bson/ns32k/3d/54020-32030LF.step

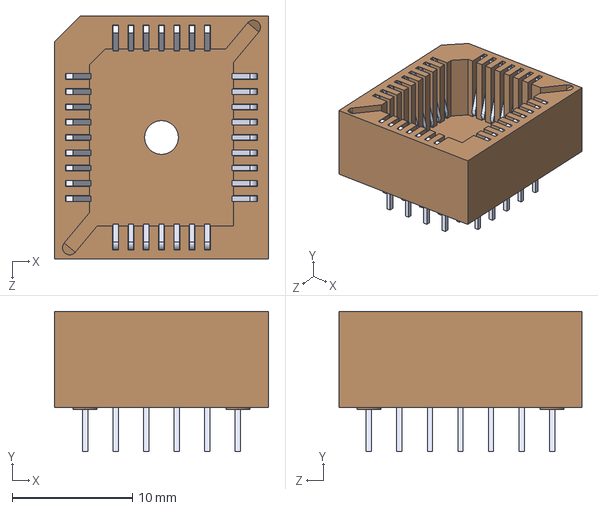
[picture p1: CAD file, 2024-07-24]
3d/54020-32030LF.step
17.8 x 11.7 x 20.2 mm
