bson/ns32k/ns32k.kicad_pcb

## KiCad design ns32k.kicad_pcb (2024-08-19)

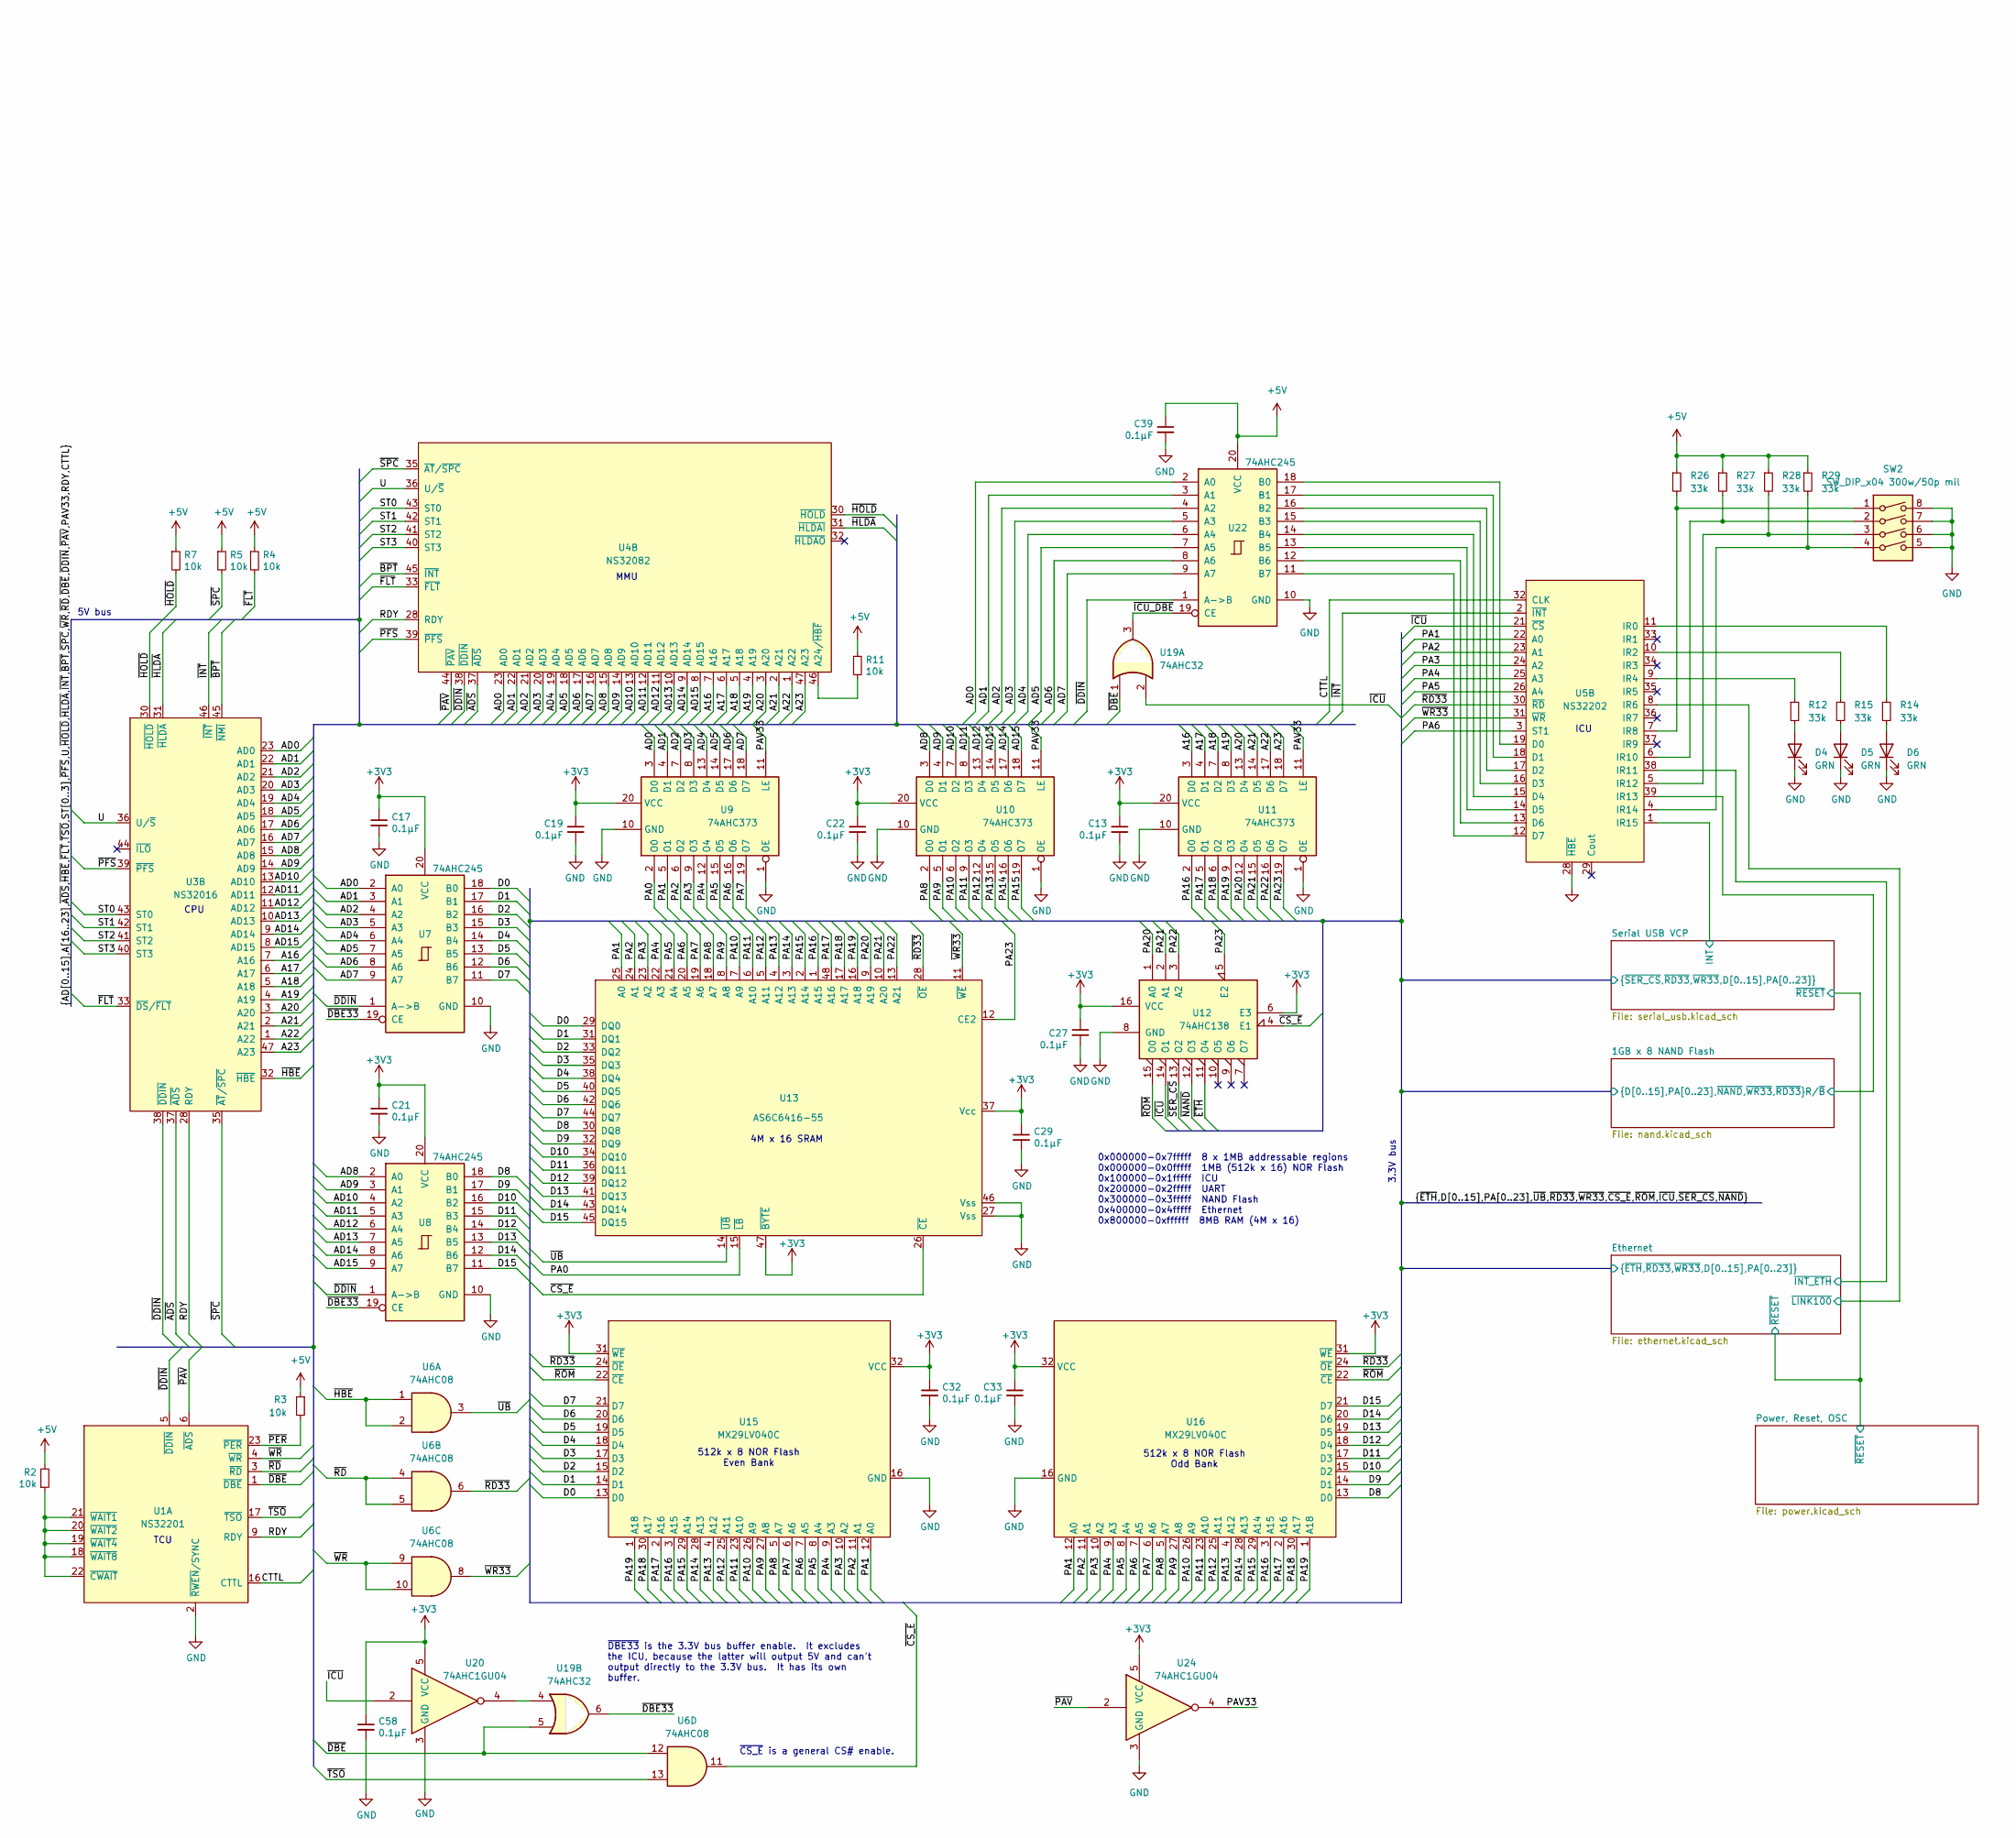
[picture p2: schematic ns32k.kicad_sch, Toy32k]

Parts:
C13, C17, C19, C21, C22, C27, C29, C32, C33, C39, C58: 0.1µF; C_0402_1005Metric; LCSC C3012376
D4, D5, D6: GRN; D_0603_1608Metric; LCSC C5246833
R2, R3, R4, R5, R7, R11: 10k; R_0402_1005Metric; LCSC C375970
R12, R14, R15, R26, R27, R28, R29: 33k; R_0402_1005Metric; LCSC C2906928
SW2: SW_DIP_x04 300w/50p mil; SW_DIP_SPSTx04_Slide_Copal_CHS-04B_W7.62mm_P1.27mm; LCSC C18198092
U1: NS32201; DIP-24_W15.24mm_Socket
U3: NS32016; DIP-48_W15.24mm_Socket
U4: NS32082; DIP-48_W15.24mm_Socket
U5: NS32202; DIP-40_W15.24mm_Socket
U6: 74AHC08; TSSOP-14_4.4x5mm_P0.65mm; LCSC C842279
U7, U8, U22: 74AHC245; TSSOP-20_4.4x6.5mm_P0.65mm; LCSC C5516
U9, U10, U11: 74AHC373; TSSOP-20_4.4x6.5mm_P0.65mm; LCSC C80242
U12: 74AHC138; TSSOP-16_4.4x5mm_P0.65mm; LCSC C352950
U13: AS6C6416-55; TSOP-I-48_18.4x12mm_P0.5mm; LCSC C1349200
U15, U16: MX29LV040C; PLCC-32_THT-Socket
U19: 74AHC32; TSSOP-14_4.4x5mm_P0.65mm; LCSC C2868909
U20, U24: 74AHC1GU04; SOT-23-5; LCSC C22384791

Connections:
+3V3: C13.1, C17.1, C19.1, C21.1, C22.1, C27.1, C29.1, C32.1, C33.1, C58.1, U7.20 (VCC), U8.20 (VCC), U9.20 (VCC), U10.20 (VCC), U11.20 (VCC), U12.6 (E3), U12.16 (VCC), U13.37 (Vcc), U13.47 (~BYTE), U15.31 (~WE), U15.32 (VCC), U16.31 (~WE), U16.32 (VCC), U20.5 (VCC), U24.5 (VCC); also elsewhere on the board
+5V: C39.1, R2.2, R3.1, R4.1, R5.1, R7.1, R11.1, R26.1, R27.1, R28.1, R29.1, U22.20 (VCC); also elsewhere on the board
/1GB x 8 NAND Flash/R/~B: U5.39 (IR13); also elsewhere on the board
/A16: U3.7 (A16), U4.7 (A16), U11.3 (D0)
/A17: U3.6 (A17), U4.6 (A17), U11.4 (D1)
/A18: U3.5 (A18), U4.5 (A18), U11.7 (D2)
/A19: U3.4 (A19), U4.4 (A19), U11.8 (D3)
/A20: U3.3 (A20), U4.3 (A20), U11.13 (D4)
/A21: U3.2 (A21), U4.2 (A21), U11.14 (D5)
/A22: U3.1 (A22), U4.1 (A22), U11.17 (D6)
/A23: U3.47 (A23), U4.47 (A23), U11.18 (D7)
/AD0: U3.23 (AD0), U4.23 (AD0), U7.2 (A0), U9.3 (D0), U22.2 (A0)
/AD1: U3.22 (AD1), U4.22 (AD1), U7.3 (A1), U9.4 (D1), U22.3 (A1)
/AD2: U3.21 (AD2), U4.21 (AD2), U7.4 (A2), U9.7 (D2), U22.4 (A2)
/AD3: U3.20 (AD3), U4.20 (AD3), U7.5 (A3), U9.8 (D3), U22.5 (A3)
/AD4: U3.19 (AD4), U4.19 (AD4), U7.6 (A4), U9.13 (D4), U22.6 (A4)
/AD5: U3.18 (AD5), U4.18 (AD5), U7.7 (A5), U9.14 (D5), U22.7 (A5)
/AD6: U3.17 (AD6), U4.17 (AD6), U7.8 (A6), U9.17 (D6), U22.8 (A6)
/AD7: U3.16 (AD7), U4.16 (AD7), U7.9 (A7), U9.18 (D7), U22.9 (A7)
/AD8: U3.15 (AD8), U4.15 (AD8), U8.2 (A0), U10.3 (D0)
/AD9: U3.14 (AD9), U4.14 (AD9), U8.3 (A1), U10.4 (D1)
/AD10: U3.13 (AD10), U4.13 (AD10), U8.4 (A2), U10.7 (D2)
/AD11: U3.12 (AD11), U4.12 (AD11), U8.5 (A3), U10.8 (D3)
/AD12: U3.11 (AD12), U4.11 (AD12), U8.6 (A4), U10.13 (D4)
/AD13: U3.10 (AD13), U4.10 (AD13), U8.7 (A5), U10.14 (D5)
/AD14: U3.9 (AD14), U4.9 (AD14), U8.8 (A6), U10.17 (D6)
/AD15: U3.8 (AD15), U4.8 (AD15), U8.9 (A7), U10.18 (D7)
/CTTL: U1.16 (CTTL), U5.32 (CLK)
/D0: U7.18 (B0), U13.29 (DQ0), U15.13 (D0); also elsewhere on the board
/D1: U7.17 (B1), U13.31 (DQ1), U15.14 (D1); also elsewhere on the board
/D2: U7.16 (B2), U13.33 (DQ2), U15.15 (D2); also elsewhere on the board
/D3: U7.15 (B3), U13.35 (DQ3), U15.17 (D3); also elsewhere on the board
/D4: U7.14 (B4), U13.38 (DQ4), U15.18 (D4); also elsewhere on the board
/D5: U7.13 (B5), U13.40 (DQ5), U15.19 (D5); also elsewhere on the board
/D6: U7.12 (B6), U13.42 (DQ6), U15.20 (D6); also elsewhere on the board
/D7: U7.11 (B7), U13.44 (DQ7), U15.21 (D7); also elsewhere on the board
/D8: U8.18 (B0), U13.30 (DQ8), U16.13 (D0)
/D9: U8.17 (B1), U13.32 (DQ9), U16.14 (D1)
/D10: U8.16 (B2), U13.34 (DQ10), U16.15 (D2)
/D11: U8.15 (B3), U13.36 (DQ11), U16.17 (D3)
/D12: U8.14 (B4), U13.39 (DQ12), U16.18 (D4)
/D13: U8.13 (B5), U13.41 (DQ13), U16.19 (D5)
/D14: U8.12 (B6), U13.43 (DQ14), U16.20 (D6)
/D15: U8.11 (B7), U13.45 (DQ15), U16.21 (D7)
/Ethernet/~INT_ETH: U5.38 (IR11); also elsewhere on the board
/Ethernet/~LINK100: U5.8 (IR6); also elsewhere on the board
/PA0: U9.2 (O0), U13.15 (~LB)
/PA1: U5.22 (A0), U9.5 (O1), U13.25 (A0), U15.12 (A0), U16.12 (A0); also elsewhere on the board
/PA2: U5.23 (A1), U9.6 (O2), U13.24 (A1), U15.11 (A1), U16.11 (A1); also elsewhere on the board
/PA3: U5.24 (A2), U9.9 (O3), U13.23 (A2), U15.10 (A2), U16.10 (A2); also elsewhere on the board
/PA4: U5.25 (A3), U9.12 (O4), U13.22 (A3), U15.9 (A3), U16.9 (A3)
/PA5: U5.26 (A4), U9.15 (O5), U13.21 (A4), U15.8 (A4), U16.8 (A4)
/PA6: U5.3 (ST1), U9.16 (O6), U13.20 (A5), U15.7 (A5), U16.7 (A5)
/PA7: U9.19 (O7), U13.19 (A6), U15.6 (A6), U16.6 (A6)
/PA8: U10.2 (O0), U13.18 (A7), U15.5 (A7), U16.5 (A7)
/PA9: U10.5 (O1), U13.8 (A8), U15.27 (A8), U16.27 (A8)
/PA10: U10.6 (O2), U13.7 (A9), U15.26 (A9), U16.26 (A9)
/PA11: U10.9 (O3), U13.6 (A10), U15.23 (A10), U16.23 (A10)
/PA12: U10.12 (O4), U13.5 (A11), U15.25 (A11), U16.25 (A11)
/PA13: U10.15 (O5), U13.4 (A12), U15.4 (A12), U16.4 (A12)
/PA14: U10.16 (O6), U13.3 (A13), U15.28 (A13), U16.28 (A13)
/PA15: U10.19 (O7), U13.2 (A14), U15.29 (A14), U16.29 (A14)
/PA16: U11.2 (O0), U13.1 (A15), U15.3 (A15), U16.3 (A15)
/PA17: U11.5 (O1), U13.48 (A16), U15.2 (A16), U16.2 (A16)
/PA18: U11.6 (O2), U13.17 (A17), U15.30 (A17), U16.30 (A17)
/PA19: U11.9 (O3), U13.16 (A18), U15.1 (A18), U16.1 (A18)
/PA20: U11.12 (O4), U12.1 (A0), U13.9 (A19)
/PA21: U11.15 (O5), U12.2 (A1), U13.10 (A20)
/PA22: U11.16 (O6), U12.3 (A2), U13.13 (A21)
/PA23: U11.19 (O7), U12.5 (E2), U13.12 (CE2)
/PAV33: U9.11 (LE), U10.11 (LE), U11.11 (LE), U24.4
/RDY: U1.9 (RDY), U3.28 (RDY), U4.28 (RDY)
/ST0: U3.43 (ST0), U4.43 (ST0)
/ST1: U3.42 (ST1), U4.42 (ST1)
/ST2: U3.41 (ST2), U4.41 (ST2)
/ST3: U3.40 (ST3), U4.40 (ST3)
/Serial USB VCP/INT: U5.1 (IR15); also elsewhere on the board
/U: U3.36 (U/~S), U4.36 (U/~S)
/~ADS: U3.37 (~ADS), U4.37 (~ADS)
/~BPT: U3.45 (~NMI), U4.45 (~INT)
/~CS_E: U6.11, U12.4 (E1), U13.26 (~CE)
/~DBE33: U7.19 (CE), U8.19 (CE), U19.6
/~DBE: U1.1 (~DBE), U6.12, U19.1, U19.5
/~DDIN: U1.5 (~DDIN), U3.38 (~DDIN), U4.38 (~DDIN), U7.1 (A->B), U8.1 (A->B), U22.1 (A->B)
/~ETH: U12.11 (O4); also elsewhere on the board
/~FLT: R4.2, U3.33 (~DS/~FLT), U4.33 (~FLT)
/~HBE: U3.32 (~HBE), U6.1, U6.2
/~HLDA: U3.31 (~HLDA), U4.31 (~HLDAI)
/~HOLD: R7.2, U3.30 (~HOLD), U4.30 (~HOLD)
/~ICU_DBE: U19.3, U22.19 (CE)
/~ICU: U5.21 (~CS), U12.14 (O1), U19.2, U20.2
/~INT: U3.46 (~INT), U5.2 (~INT)
/~NAND: U12.12 (O3); also elsewhere on the board
/~PAV: U1.6 (~ADS), U4.44 (~PAV), U24.2
/~PER: R3.2, U1.23 (~PER)
/~PFS: U3.39 (~PFS), U4.39 (~PFS)
/~RD33: U5.30 (~RD), U6.6, U13.28 (~OE), U15.24 (~OE), U16.24 (~OE); also elsewhere on the board
/~RD: U1.3 (~RD), U6.4, U6.5
/~ROM: U12.15 (O0), U15.22 (~CE), U16.22 (~CE)
/~SER_CS: U12.13 (O2); also elsewhere on the board
/~SPC: R5.2, U3.35 (~AT/~SPC), U4.35 (~AT/~SPC)
/~TSO: U1.17 (~TSO), U6.13
/~UB: U6.3, U13.14 (~UB)
/~WR33: U5.31 (~WR), U6.8, U13.11 (~WE); also elsewhere on the board
/~WR: U1.4 (~WR), U6.9, U6.10
GND: C13.2, C17.2, C19.2, C21.2, C22.2, C27.2, C29.2, C32.2, C33.2, C39.2, C58.2, D4.1 (K), D5.1 (K), D6.1 (K), SW2.5, SW2.6, SW2.7, SW2.8, U1.2 (~RWEN/SYNC), U5.28 (~HBE), U7.10 (GND), U8.10 (GND), U9.1 (OE), U9.10 (GND), U10.1 (OE), U10.10 (GND), U11.1 (OE), U11.10 (GND), U12.8 (GND), U13.27 (Vss), U13.46 (Vss), U15.16 (GND), U16.16 (GND), U20.3 (GND), U22.10 (GND), U24.3 (GND); also elsewhere on the board
unnamed: D4.2 (A), R12.2
unnamed: D5.2 (A), R15.2
unnamed: D6.2 (A), R14.2
unnamed: R2.1, U1.18 (~WAIT8), U1.19 (~WAIT4), U1.20 (~WAIT2), U1.21 (~WAIT1), U1.22 (~CWAIT)
unnamed: R11.2, U4.46 (A24/~HBF)
unnamed: R14.1, U5.11 (IR0)
unnamed: R15.1, U5.10 (IR2)
unnamed: R12.1, U5.9 (IR4)
unnamed: R26.2, SW2.1, U5.7 (IR8)
unnamed: R27.2, SW2.2, U5.6 (IR10)
unnamed: R28.2, SW2.3, U5.5 (IR12)
unnamed: R29.2, SW2.4, U5.4 (IR14)
unnamed: U19.4, U20.4
unnamed: U5.19 (D0), U22.18 (B0)
unnamed: U5.18 (D1), U22.17 (B1)
unnamed: U5.17 (D2), U22.16 (B2)
unnamed: U5.16 (D3), U22.15 (B3)
unnamed: U5.15 (D4), U22.14 (B4)
unnamed: U5.14 (D5), U22.13 (B5)
unnamed: U5.13 (D6), U22.12 (B6)
unnamed: U5.12 (D7), U22.11 (B7)

Notes on the sheet:
~{CS_E} is a general CS# enable.
0x000000-0x7fffff 8 x 1MB addressable regions 0x000000-0x0fffff 1MB (512k x 16) NOR Flash 0x100000-0x1fffff ICU 0x200000-0x2fffff UART 0x300000-0x3fffff NAND Flash 0x400000-0x4fffff Ethernet 0x800000-0xffffff 8MB RAM (4M x 16)
MMU
CPU
5V bus
512k x 8 NOR Flash Odd Bank
4M x 16 SRAM
~{DBE33} is the 3.3V bus buffer enable. It excludes the ICU, because the latter will output 5V and can't output directly to the 3.3V bus. It has its own buffer.
ICU
3.3V bus
TCU
512k x 8 NOR Flash Even Bank

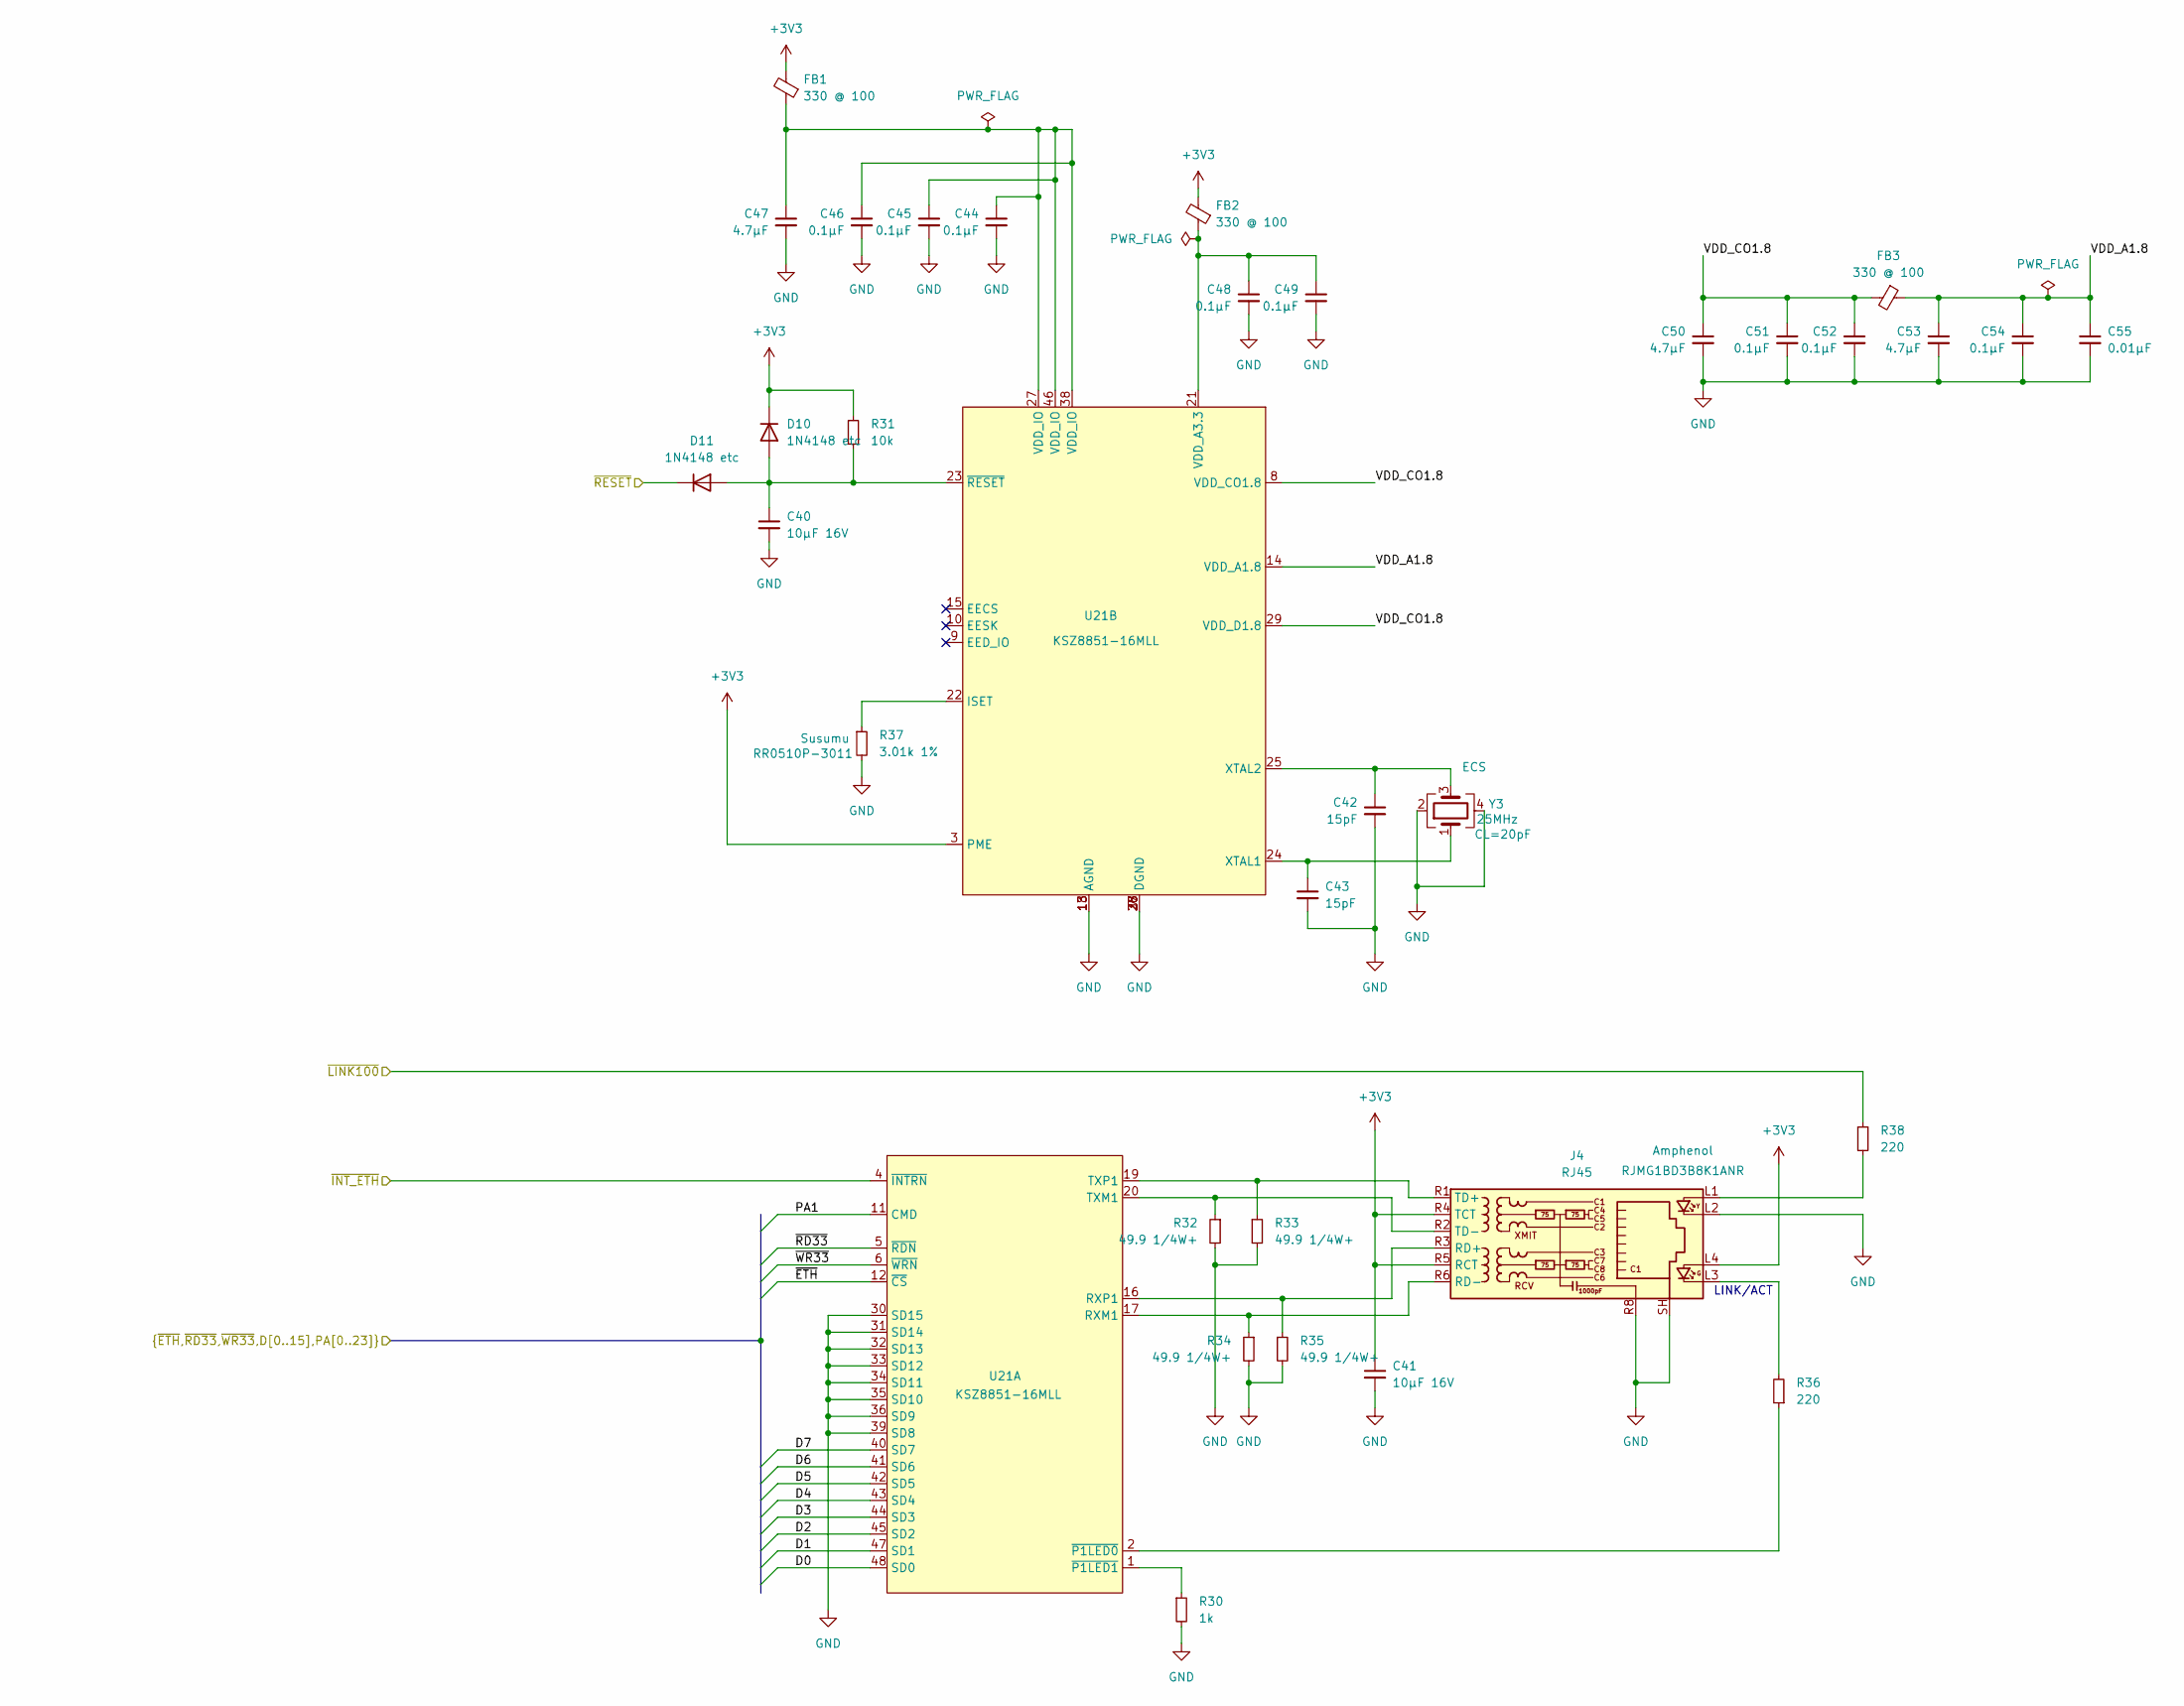
[picture p3: schematic ethernet.kicad_sch, Toy32k]

Parts:
C40, C41: 10µF 16V; C_0603_1608Metric; LCSC C109457
C42, C43: 15pF; C_0402_1005Metric; LCSC C1852854
C44, C45, C46, C48, C49, C51, C52, C54: 0.1µF; C_0402_1005Metric; LCSC C3012376
C47, C50, C53: 4.7µF; C_0805_2012Metric; LCSC C84718
C55: 0.01µF; C_0402_1005Metric; LCSC C327025
D10, D11: 1N4148 etc; D_0603_1608Metric; LCSC C2902912
FB1, FB2, FB3: 330 @ 100; L_0402_1005Metric; LCSC C108308
J4: RJ45; RJ45_Amphenol_RJMG1BD3B8K1ANR; Part RJMG1BD3B8K1ANR
R30: 1k; R_0402_1005Metric; LCSC C139047
R31: 10k; R_0402_1005Metric; LCSC C375970
R32, R33, R34, R35: 49.9 1/4W+; R_0805_2012Metric; LCSC C4088942
R36, R38: 220; R_0402_1005Metric; LCSC C453594
R37: 3.01k 1%; R_0402_1005Metric; Part RR0510P-3011; LCSC C25889
U21: KSZ8851-16MLL; LQFP-48_7x7mm_P0.5mm; LCSC C633713
Y3: 25MHz; Crystal_SMD_3225-4Pin_3.2x2.5mm; LCSC C7294571

Connections:
+3V3: C41.1, D10.1 (K), FB1.2, FB2.2, J4.L4, J4.R4 (TCT), J4.R5 (RCT), R31.1, U21.3 (PME); also elsewhere on the board
/D0: U21.48 (SD0); also elsewhere on the board
/D1: U21.47 (SD1); also elsewhere on the board
/D2: U21.45 (SD2); also elsewhere on the board
/D3: U21.44 (SD3); also elsewhere on the board
/D4: U21.43 (SD4); also elsewhere on the board
/D5: U21.42 (SD5); also elsewhere on the board
/D6: U21.41 (SD6); also elsewhere on the board
/D7: U21.40 (SD7); also elsewhere on the board
/Ethernet/VDD_A1.8: C53.1, C54.1, C55.1, FB3.1, U21.14 (VDD_A1.8)
/Ethernet/VDD_CO1.8: C50.1, C51.1, C52.1, FB3.2, U21.8 (VDD_CO1.8), U21.29 (VDD_D1.8)
/Ethernet/~INT_ETH: U21.4 (~INTRN); also elsewhere on the board
/Ethernet/~LINK100: R38.1; also elsewhere on the board
/Ethernet/~RESET: D11.1 (K); also elsewhere on the board
/PA1: U21.11 (CMD); also elsewhere on the board
/~ETH: U21.12 (~CS); also elsewhere on the board
/~RD33: U21.5 (~RDN); also elsewhere on the board
/~WR33: U21.6 (~WRN); also elsewhere on the board
GND: C40.2, C41.2, C42.2, C43.2, C44.2, C45.2, C46.2, C47.2, C48.2, C49.2, C50.2, C51.2, C52.2, C53.2, C54.2, C55.2, J4.L2, J4.R8, J4.SH, R30.2, R32.2, R33.2, R34.2, R35.2, R37.2, U21.7 (DGND), U21.13 (AGND), U21.18 (AGND), U21.26 (DGND), U21.28 (DGND), U21.30 (SD15), U21.31 (SD14), U21.32 (SD13), U21.33 (SD12), U21.34 (SD11), U21.35 (SD10), U21.36 (SD9), U21.37 (DGND), U21.39 (SD8), Y3.2, Y3.4; also elsewhere on the board
unnamed: C44.1, C45.1, C46.1, C47.1, FB1.1, U21.27 (VDD_IO), U21.38 (VDD_IO), U21.46 (VDD_IO)
unnamed: C40.1, D10.2 (A), D11.2 (A), R31.2, U21.23 (~RESET)
unnamed: J4.L1, R38.2
unnamed: J4.L3, R36.2
unnamed: J4.R3 (RD+), R35.1, U21.16 (RXP1)
unnamed: J4.R6 (RD-), R34.1, U21.17 (RXM1)
unnamed: J4.R1 (TD+), R33.1, U21.19 (TXP1)
unnamed: J4.R2 (TD-), R32.1, U21.20 (TXM1)
unnamed: R36.1, U21.2 (~P1LED0)
unnamed: R30.1, U21.1 (~P1LED1)
unnamed: R37.1, U21.22 (ISET)
unnamed: C48.1, C49.1, FB2.1, U21.21 (VDD_A3.3)
unnamed: C43.1, U21.24 (XTAL1), Y3.1
unnamed: C42.1, U21.25 (XTAL2), Y3.3

Notes on the sheet:
LINK/ACT

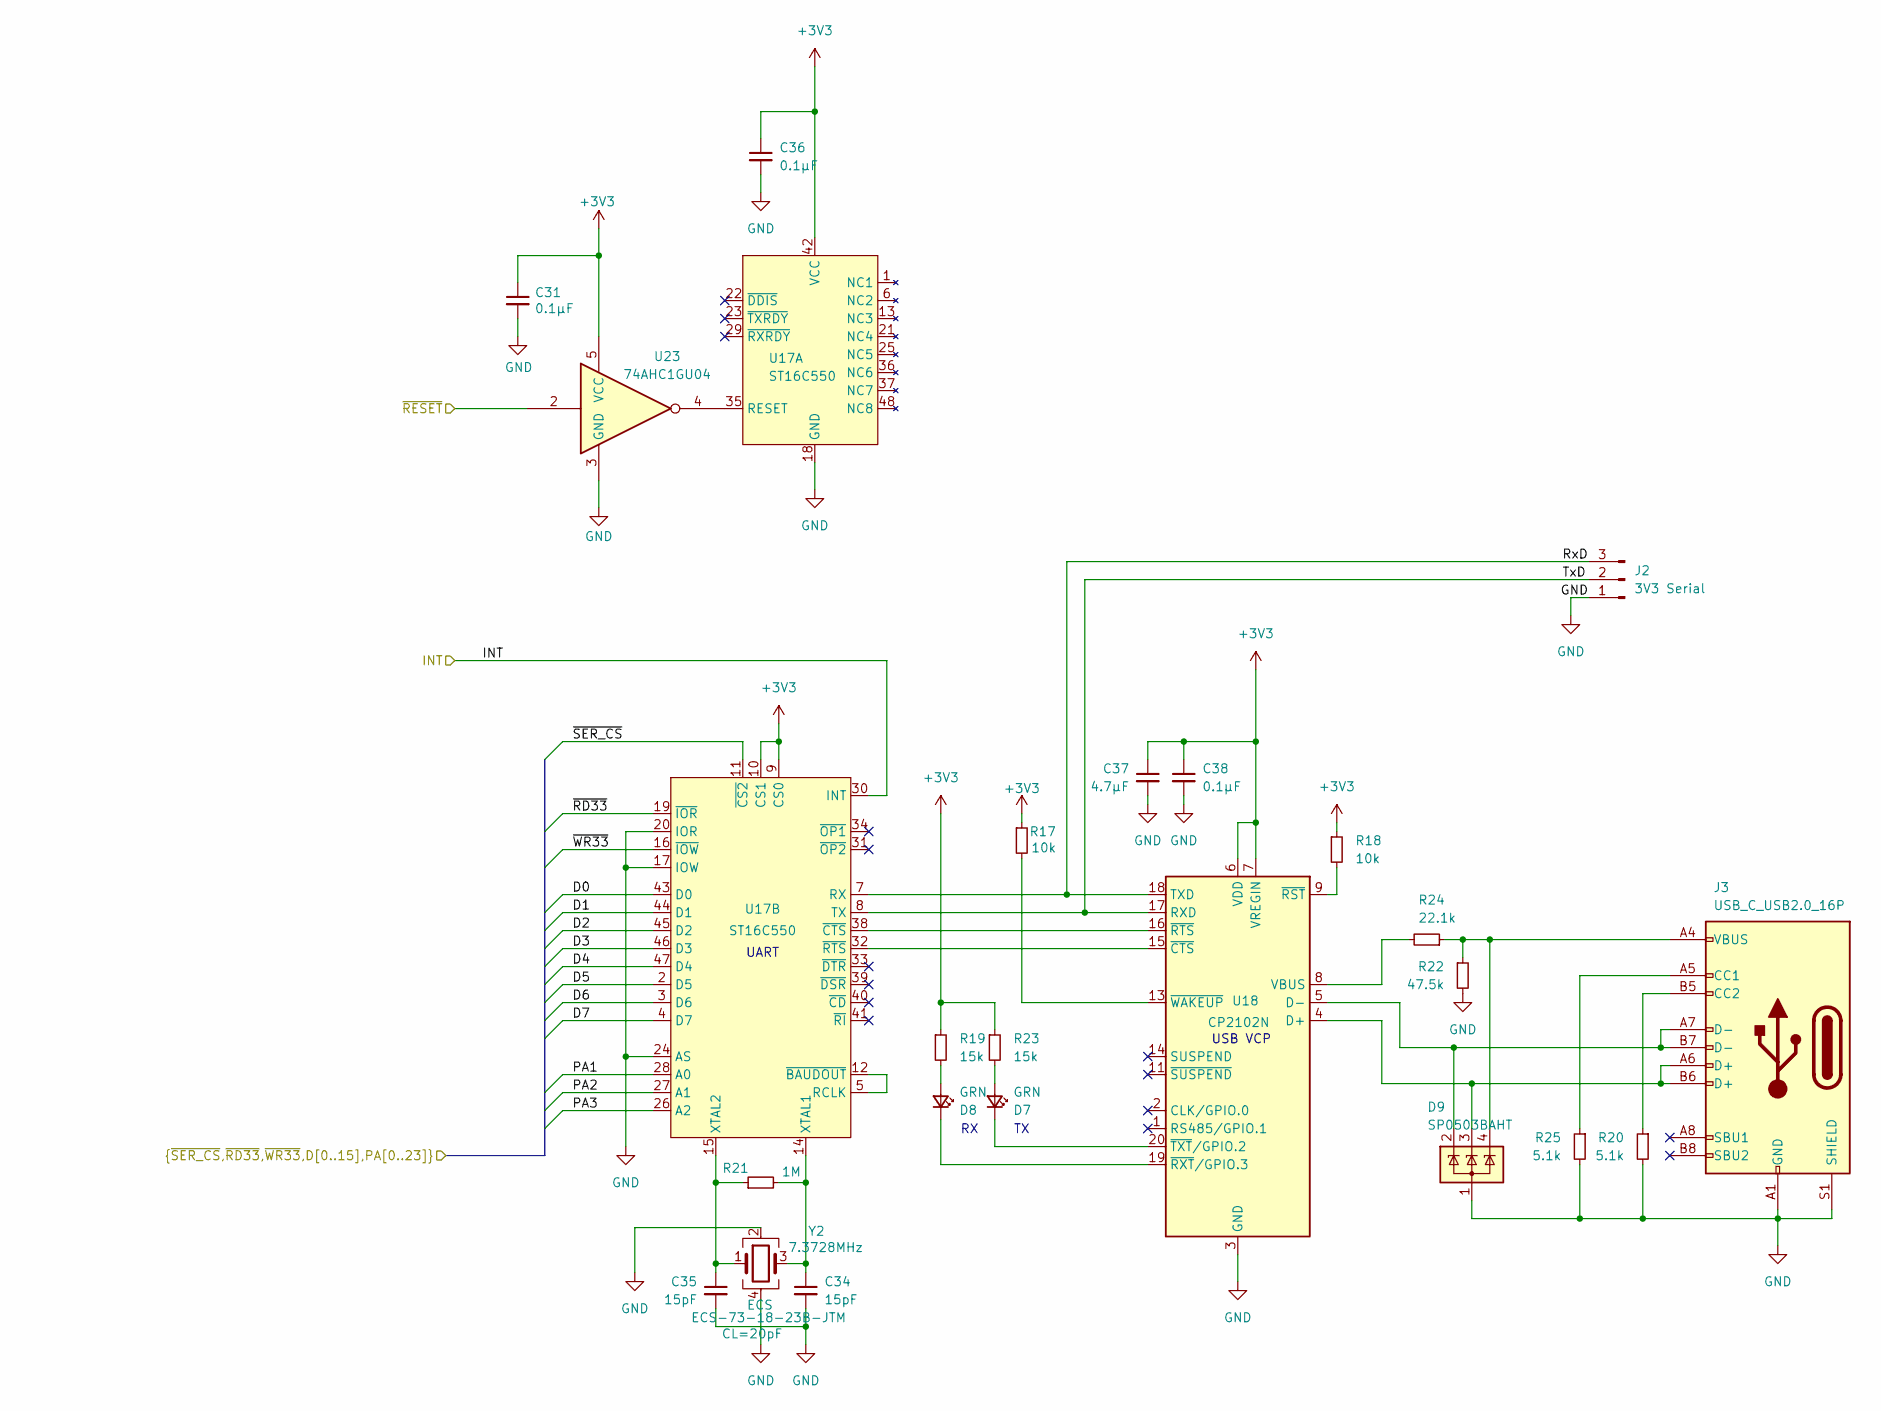
[picture p4: schematic serial_usb.kicad_sch, Toy32k]

Parts:
C31, C36, C38: 0.1µF; C_0402_1005Metric; LCSC C3012376
C34, C35: 15pF; C_0402_1005Metric; LCSC C1852854
C37: 4.7µF; C_0805_2012Metric; LCSC C84718
D7, D8: GRN; D_0603_1608Metric; LCSC C5246833
D9: SP0503BAHT; SOT-143; LCSC C5337181
J2: 3V3 Serial; PinHeader_1x03_P2.54mm_Vertical
J3: USB_C_USB2.0_16P; USB_C_Receptacle_HCTL_HC-TYPE-C-16P-01A; LCSC C2909599
R17, R18: 10k; R_0402_1005Metric; LCSC C375970
R19, R23: 15k; R_0402_1005Metric; LCSC C850820
R20, R25: 5.1k; R_0402_1005Metric; LCSC C384321
R21: 1M; R_0402_1005Metric; LCSC C4334825
R22: 47.5k; R_0402_1005Metric; LCSC C3015870
R24: 22.1k; R_0402_1005Metric; LCSC C2929993
U17: ST16C550; TQFP-48_7x7mm_P0.5mm; LCSC C2653190
U18: CP2102N; CP2102N-QFN20; LCSC C969913
U23: 74AHC1GU04; SOT-23-5; LCSC C22384791
Y2: 7.3728MHz; Crystal_SMD_0603-4Pin_6.0x3.5mm; Part ECS-73-18-23B-JTM

Connections:
+3V3: C31.1, C36.1, C37.1, C38.1, R17.1, R18.1, R19.1, R23.1, U17.9 (CS0), U17.10 (CS1), U17.42 (VCC), U18.6 (VDD), U18.7 (VREGIN), U23.5 (VCC); also elsewhere on the board
/D0: U17.43 (D0); also elsewhere on the board
/D1: U17.44 (D1); also elsewhere on the board
/D2: U17.45 (D2); also elsewhere on the board
/D3: U17.46 (D3); also elsewhere on the board
/D4: U17.47 (D4); also elsewhere on the board
/D5: U17.2 (D5); also elsewhere on the board
/D6: U17.3 (D6); also elsewhere on the board
/D7: U17.4 (D7); also elsewhere on the board
/Ethernet/~RESET: U23.2; also elsewhere on the board
/PA1: U17.28 (A0); also elsewhere on the board
/PA2: U17.27 (A1); also elsewhere on the board
/PA3: U17.26 (A2); also elsewhere on the board
/Serial USB VCP/INT: U17.30 (INT); also elsewhere on the board
/Serial USB VCP/RxD: J2.3, U17.7 (RX), U18.18 (TXD)
/Serial USB VCP/TxD: J2.2, U17.8 (TX), U18.17 (RXD)
/~RD33: U17.19 (~IOR); also elsewhere on the board
/~SER_CS: U17.11 (~CS2); also elsewhere on the board
/~WR33: U17.16 (~IOW); also elsewhere on the board
GND: C31.2, C34.2, C35.2, C36.2, C37.2, C38.2, D9.1 (A), J2.1, J3.A1 (GND), J3.A12 (GND), J3.B1 (GND), J3.B12 (GND), J3.S1 (SHIELD), R20.2, R22.2, R25.2, U17.17 (IOW), U17.18 (GND), U17.20 (IOR), U17.24 (AS), U18.3 (GND), U18.12 (GND), U23.3 (GND), Y2.2, Y2.4; also elsewhere on the board
unnamed: D7.2 (A), R23.2
unnamed: D7.1 (K), U18.20 (~TXT/GPIO.2)
unnamed: D8.2 (A), R19.2
unnamed: D8.1 (K), U18.19 (~RXT/GPIO.3)
unnamed: D9.4 (K), J3.A4 (VBUS), J3.A9 (VBUS), J3.B4 (VBUS), J3.B9 (VBUS), R22.1, R24.1
unnamed: J3.A5 (CC1), R25.1
unnamed: J3.B5 (CC2), R20.1
unnamed: U17.35 (RESET), U23.4
unnamed: U17.5 (RCLK), U17.12 (~BAUDOUT)
unnamed: C34.1, R21.2, U17.14 (XTAL1), Y2.3
unnamed: C35.1, R21.1, U17.15 (XTAL2), Y2.1
unnamed: U17.38 (~CTS), U18.16 (~RTS)
unnamed: U17.32 (~RTS), U18.15 (~CTS)
unnamed: D9.3 (K), J3.A6 (D+), J3.B6 (D+), U18.4 (D+)
unnamed: D9.2 (K), J3.A7 (D-), J3.B7 (D-), U18.5 (D-)
unnamed: R24.2, U18.8 (VBUS)
unnamed: R18.2, U18.9 (~RST)
unnamed: R17.2, U18.13 (~WAKEUP)

Notes on the sheet:
USB VCP
UART

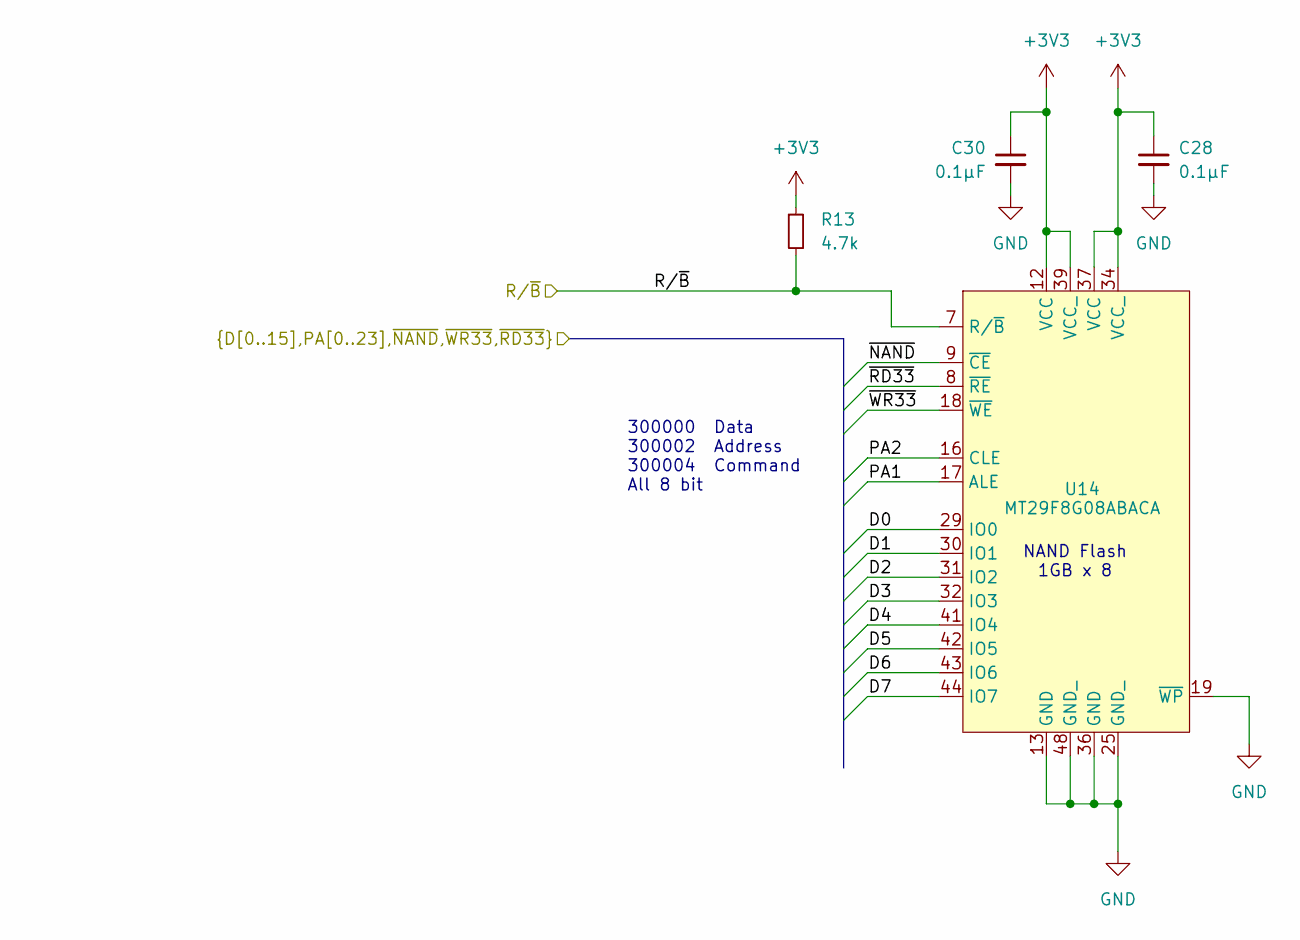
[picture p5: schematic nand.kicad_sch, Toy32k]

Parts:
C28, C30: 0.1µF; C_0402_1005Metric; LCSC C3012376
R13: 4.7k; R_0402_1005Metric; LCSC C25940
U14: MT29F8G08ABACA; TSOP-I-48_18.4x12mm_P0.5mm; LCSC C400999

Connections:
+3V3: C28.1, C30.1, R13.1, U14.12 (VCC), U14.34 (VCC_), U14.37 (VCC), U14.39 (VCC_); also elsewhere on the board
/1GB x 8 NAND Flash/R/~B: R13.2, U14.7 (R/~B); also elsewhere on the board
/D0: U14.29 (IO0); also elsewhere on the board
/D1: U14.30 (IO1); also elsewhere on the board
/D2: U14.31 (IO2); also elsewhere on the board
/D3: U14.32 (IO3); also elsewhere on the board
/D4: U14.41 (IO4); also elsewhere on the board
/D5: U14.42 (IO5); also elsewhere on the board
/D6: U14.43 (IO6); also elsewhere on the board
/D7: U14.44 (IO7); also elsewhere on the board
/PA1: U14.17 (ALE); also elsewhere on the board
/PA2: U14.16 (CLE); also elsewhere on the board
/~NAND: U14.9 (~CE); also elsewhere on the board
/~RD33: U14.8 (~RE); also elsewhere on the board
/~WR33: U14.18 (~WE); also elsewhere on the board
GND: C28.2, C30.2, U14.13 (GND), U14.19 (~WP), U14.25 (GND_), U14.36 (GND), U14.48 (GND_); also elsewhere on the board

Notes on the sheet:
NAND Flash 1GB x 8
300000 Data 300002 Address 300004 Command All 8 bit
