bson/ns32k/ns32k.kicad_pcb

## KiCad design ns32k.kicad_pcb (continued)

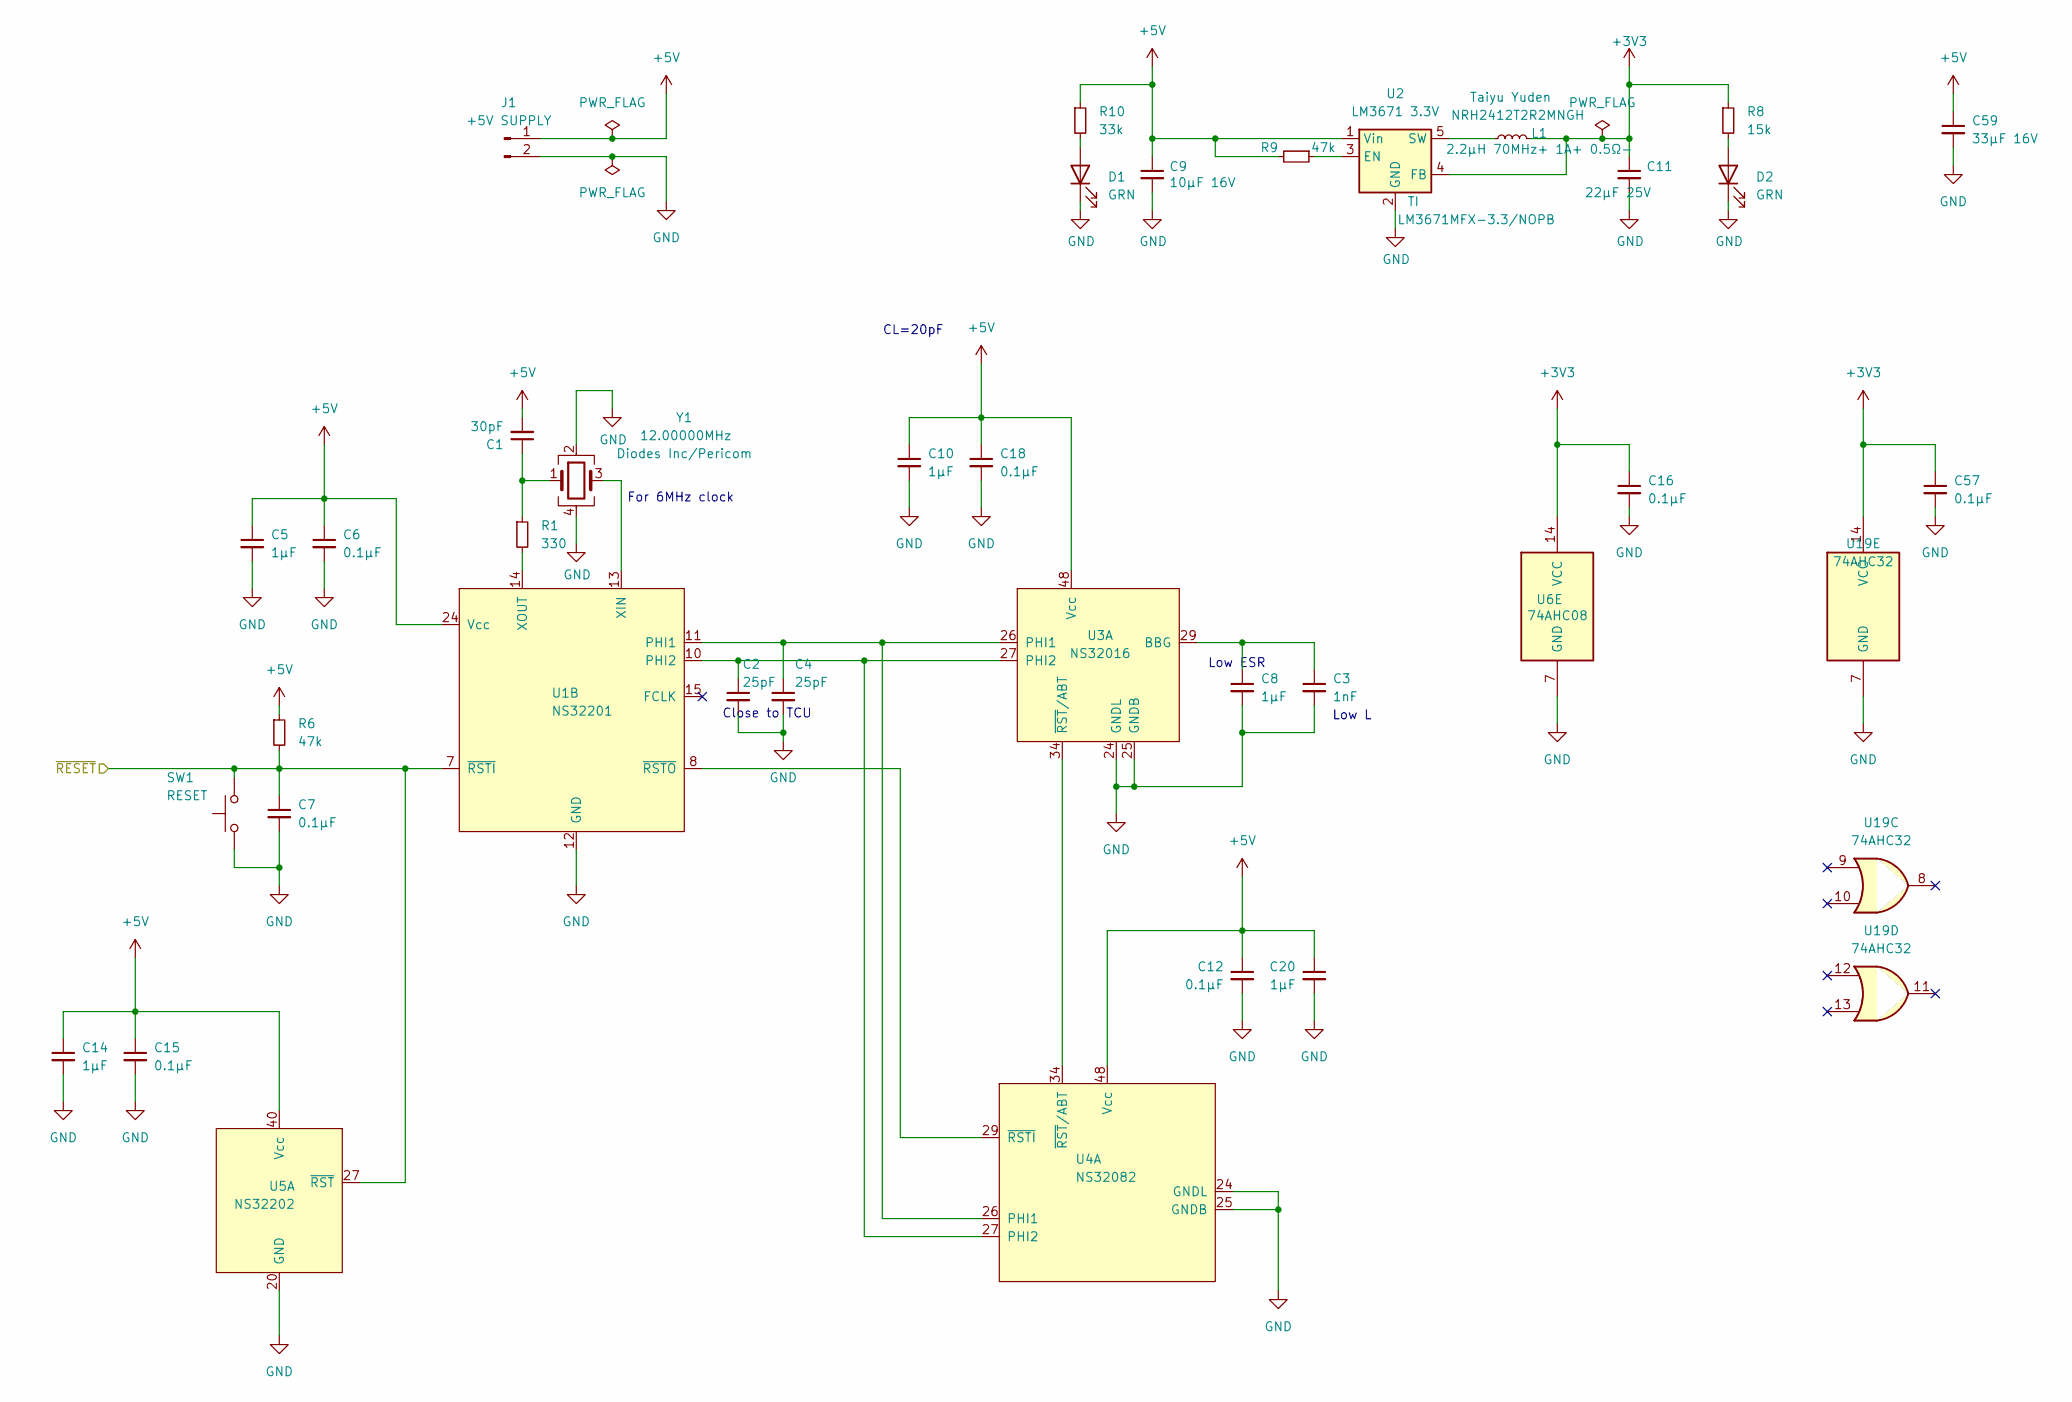
[picture p6: schematic power.kicad_sch, Toy32k]

Parts:
C1: 30pF; C_0402_1005Metric; LCSC C312063
C2, C4: 25pF; C_0402_1005Metric; LCSC C696895
C3: 1nF; C_0402_1005Metric; LCSC C696895
C5, C8, C10, C14, C20: 1µF; C_0603_1608Metric; LCSC C5189821
C6, C7, C12, C15, C16, C18, C57: 0.1µF; C_0402_1005Metric; LCSC C3012376
C9: 10µF 16V; C_0603_1608Metric; LCSC C109457
C11: 22µF 25V; C_0805_2012Metric; LCSC C258782
C59: 33µF 16V; C_1206_3216Metric; LCSC C342606
D1, D2: GRN; D_0603_1608Metric; LCSC C5246833
J1: +5V SUPPLY; PinHeader_1x02_P2.54mm_Vertical
L1: 2.2µH 70MHz+ 1A+ 0.5Ω-; L_Taiyo-Yuden_NR-24xx; Part NRH2412T2R2MNGH
R1: 330; R_0402_1005Metric; LCSC C186314
R6: 47k; R_0402_1005Metric; LCSC C139047
R8: 15k; R_0402_1005Metric; LCSC C850820
R9: 47k; R_0402_1005Metric; LCSC C3017507
R10: 33k; R_0402_1005Metric; LCSC C2906928
SW1: RESET; SW_SPST_CK_RS282G05A3
U1: NS32201; DIP-24_W15.24mm_Socket
U2: LM3671 3.3V; TSOT-23-5; Part LM3671MFX-3.3/NOPB; LCSC C201586
U3: NS32016; DIP-48_W15.24mm_Socket
U4: NS32082; DIP-48_W15.24mm_Socket
U5: NS32202; DIP-40_W15.24mm_Socket
U6: 74AHC08; TSSOP-14_4.4x5mm_P0.65mm; LCSC C842279
U19: 74AHC32; TSSOP-14_4.4x5mm_P0.65mm; LCSC C2868909
Y1: 12.00000MHz; FH12000001; LCSC C7294547

Connections:
+3V3: C11.1, C16.1, C57.1, L1.2, R8.1, U2.4 (FB), U6.14 (VCC), U19.14 (VCC); also elsewhere on the board
+5V: C1.2, C5.1, C6.1, C9.1, C10.1, C12.1, C14.1, C15.1, C18.1, C20.1, C59.1, J1.1, R6.1, R9.2, R10.1, U1.24 (Vcc), U2.1 (Vin), U3.48 (Vcc), U4.48 (Vcc), U5.40 (Vcc); also elsewhere on the board
/Ethernet/~RESET: C7.1, R6.2, SW1.1, U1.7 (~RSTI), U5.27 (~RST); also elsewhere on the board
GND: C2.2, C3.2, C4.2, C5.2, C6.2, C7.2, C8.2, C9.2, C10.2, C11.2, C12.2, C14.2, C15.2, C16.2, C18.2, C20.2, C57.2, C59.2, D1.1 (K), D2.1 (K), J1.2, SW1.2, U1.12 (GND), U2.2 (GND), U3.24 (GNDL), U3.25 (GNDB), U4.24 (GNDL), U4.25 (GNDB), U5.20 (GND), U6.7 (GND), U19.7 (GND), Y1.2, Y1.4; also elsewhere on the board
unnamed: C1.1, R1.1, Y1.1
unnamed: D1.2 (A), R10.2
unnamed: D2.2 (A), R8.2
unnamed: C4.1, U1.11 (PHI1), U3.26 (PHI1), U4.26 (PHI1)
unnamed: C2.1, U1.10 (PHI2), U3.27 (PHI2), U4.27 (PHI2)
unnamed: U1.13 (XIN), Y1.3
unnamed: R1.2, U1.14 (XOUT)
unnamed: U1.8 (~RSTO), U4.29 (~RSTI)
unnamed: R9.1, U2.3 (EN)
unnamed: L1.1, U2.5 (SW)
unnamed: C3.1, C8.1, U3.29 (BBG)
unnamed: U3.34 (~RST/ABT), U4.34 (~RST/ABT)

Notes on the sheet:
Low L
For 6MHz clock
CL=20pF
Close to TCU
Low ESR

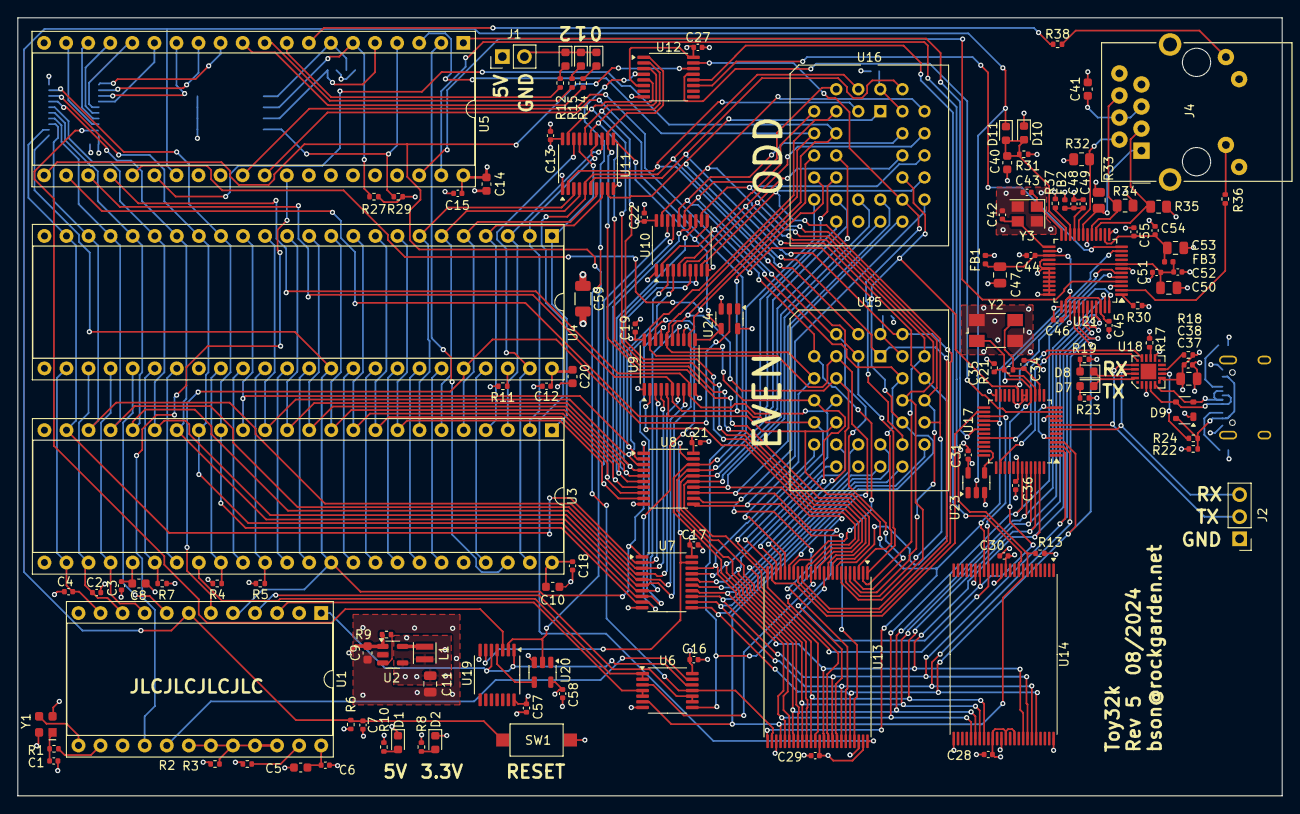
[picture p7: board ns32k.kicad_pcb from above]

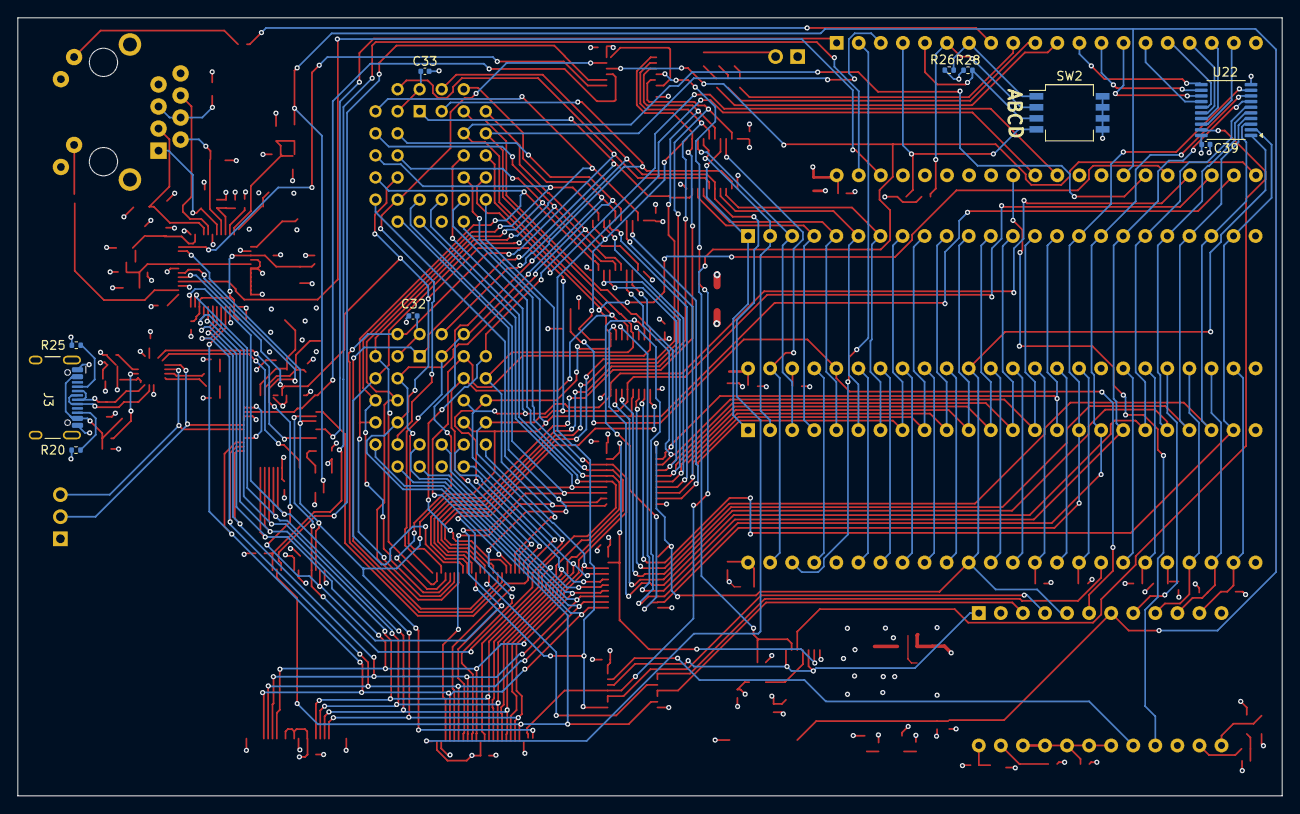
[picture p8: board ns32k.kicad_pcb from below]

Board: 4 copper layers, 145.5 x 89.6 mm, 138 parts (10 on the bottom side), 176 nets.
