bson/ns32k/(commit log)

2024-07-24 initial commit; as sent to JLCPCB for Rev 1
    [54020-32030LF.step, nand.kicad_sch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]
2024-07-24 add datasheets
    [ns32k.kicad_sch]
2024-07-25 add NS32k manuals
    [ns32k.kicad_pcb]
2024-07-25 add ICU int ack decoding
    [ns32k.kicad_pcb, ns32k.kicad_sch, power.kicad_sch]
2024-07-25 move ICU# delay to after decode
    [nand.kicad_sch, ns32k.kicad_pcb, ns32k.kicad_sch, power.kicad_sch, serial_usb.kicad_sch]
2024-07-25 fix VUSB bug
    [ns32k.kicad_pcb, ns32k.kicad_sch, serial_usb.kicad_sch]
2024-07-25 add reset button
    [ns32k.kicad_pcb, power.kicad_sch]
2024-07-25 cleanups, DRC
    [ns32k.kicad_pcb, ns32k.kicad_sch]
2024-07-26 add ethernet to schematic
    [ethernet.kicad_sch, ns32k.kicad_sch]
2024-07-26 fix DRC errors, add RJ45 step model
    [ethernet.kicad_sch, ns32k.kicad_pcb, ns32k.kicad_sch, power.kicad_sch]
2024-07-26 save unsaved changed
    [ns32k.kicad_pcb]
2024-07-27 route ethernet, reroute USB
    [ethernet.kicad_sch, ns32k.kicad_pcb, ns32k.kicad_sch, serial_usb.kicad_sch]
2024-07-27 correct datasheet, update 4148 footprint from 0805 to 0603
    [ethernet.kicad_sch, ns32k.kicad_pcb]
2024-07-27 set USB-C 3D model
    [ns32k.kicad_pcb]
2024-07-27 cosmetic changes
    [ns32k.kicad_pcb]
2024-07-27 add 0R's to ICU CS logic
    [ns32k.kicad_pcb, ns32k.kicad_sch]
2024-07-27 use ICU even pins for GPIO
    [ns32k.kicad_pcb, ns32k.kicad_sch]
2024-07-27 add jumpers, much cleanup
    [ethernet.kicad_sch, ns32k.kicad_pcb, ns32k.kicad_sch]
2024-07-27 add buffer to ICU
    [ns32k.kicad_pcb, ns32k.kicad_sch, power.kicad_sch]
2024-07-27 layout ICU buffering
    [ns32k.kicad_pcb, ns32k.kicad_sch]
2024-07-28 add TI PW footprint drawing
2024-07-28 add 33uF 1206 16V reservoir cap to 5V
    [ns32k.kicad_pcb, ns32k.kicad_sch, power.kicad_sch]
2024-07-28 generate Rev 2 gerbers
    [ns32k-B_Cu.gbl, ns32k-B_Mask.gbs, ns32k-B_Paste.gbp, ns32k-B_Silkscreen.gbo, ns32k-Edge_Cuts.gm1, ns32k-F_Cu.gtl, ns32k-F_Mask.gts, ns32k-F_Paste.gtp]
2024-07-28 update rev2 gerbers
    [ns32k-B_Cu.gbl, ns32k-B_Mask.gbs, ns32k-B_Paste.gbp, ns32k-B_Silkscreen.gbo, ns32k-Edge_Cuts.gm1, ns32k-F_Cu.gtl, ns32k-F_Mask.gts, ns32k-F_Paste.gtp]
2024-07-30 fix ICU addressing error
    [ns32k.kicad_pcb, ns32k.kicad_sch, power.kicad_sch]
2024-07-30 Rev3 gerbers
    [ethernet.kicad_sch, nand.kicad_sch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]
2024-08-02 Power ICU AHC245 buffer with +5V
    [ns32k.kicad_pcb, ns32k.kicad_sch]
2024-08-03 add pullup to NAND R/B# as per ONFI 1.0 spec
    [nand.kicad_sch, ns32k.kicad_pcb]
2024-08-10 update value of 49.9 ethernet resistors to reflect 1/4 W
    [ethernet.kicad_sch]
2024-08-11 fix address decoding
    [ethernet.kicad_sch, nand.kicad_sch, ns32k.kicad_pcb, ns32k.kicad_sch, power.kicad_sch, serial_usb.kicad_sch]
2024-08-11 add rev4 gerbers, bom files
    [ethernet.kicad_sch, lcsc_rev4.csv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]
2024-08-12 various changes, add LCSC part #s
    [ethernet.kicad_sch, lcsc_rev4.csv, nand.kicad_sch, ns32k.kicad_pcb, ns32k.kicad_sch, power.kicad_sch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]
2024-08-12 revert crystal footprints back from LCSC parts
    [ns32k.kicad_pcb, ns32k.kicad_sch, power.kicad_sch]
2024-08-12 update gerbers
    [ns32k-B_Cu.gbl, ns32k-B_Mask.gbs, ns32k-B_Paste.gbp, ns32k-B_Silkscreen.gbo, ns32k-Edge_Cuts.gm1, ns32k-F_Cu.gtl, ns32k-F_Mask.gts, ns32k-F_Paste.gtp]
2024-08-13 restore L1 TY NHR24xx FP
    [ns32k.kicad_pcb, power.kicad_sch]
2024-08-16 rev4 errata, fix in main
    [power.kicad_sch]
2024-08-17 AS is active high, and we tie it to GND
    [ns32k.kicad_pcb, serial_usb.kicad_sch]
2024-08-17 fix a few bugs
    [ethernet.kicad_sch, nand.kicad_sch, ns32k.kicad_pcb, ns32k.kicad_sch, power.kicad_sch, serial_usb.kicad_sch]
2024-08-19 save changes
    [ns32k.kicad_sch]
2024-08-19 fix UART addressing, generate gerbers
    [ns32k-B_Cu.gbl, ns32k-B_Mask.gbs, ns32k-B_Paste.gbp, ns32k-B_Silkscreen.gbo, ns32k-Edge_Cuts.gm1, ns32k-F_Cu.gtl, ns32k-F_Mask.gts, ns32k-F_Paste.gtp]
